EnvisionGForce/Practicum/README.md

# ECE411 Practicum Project

**Team:** Envision GForce (Team 16)

**Members:** Thomas Harris, Jacbob Metoxen, Eric Schulte, Seth Starr

**Advisor:** Andrew Greenberg

**Project Description:** Intuitive Lateral G-Force Display (Direction and magnitude)
