EnvisionGForce/Practicum/Practicum HW/3x_Practicum_Ideas.txt

Envision GForce (Team 16)
10/17/2019
ECE 411
HW 2: 3x Practicum Ideas

1. Chosen idea: Intuitive Lateral G-Force Display (Direction and magnitude)

This device will display the direction and magnitude of lateral acceleration vectors. A basic conceptual description of the output display can be seen on the left side in this video: https://www.youtube.com/watch?v=zJRh9FG83d0. 

The purpose is to intuitively and instantaneously convey the direction and magnitude of the lateral acceleration acting upon the device (or an object the device is attached to).

The sensor will be an accelerometer, or a set of accelerometers, which will output direction and magnitude data to the processor. We plan on using either the ATMega328 or the ATMega32U4 for the processor in our device. The actuator will either be a matrix of LEDs, or perhaps an LCD screen if we can figure out the necessary coding.

Our initial idea is to have a '*-shaped' matrix consisting of 3-5 LEDs on each of the 6 lobes. Each lobe will indicate a rough direction, and the number of illuminated LEDs will indicate magnitude. It would be cool to also display the magnitude numerically using an LCD or 7-segment display.

2. Weather Station

This device will function as a mini weather station that can display temperature, wind speed, wind direction, and humidity. The various sensors will interface with a microcontroller and display to an LCD on the device. The sensors needed should be readily available and relatively easy to interface with. If possible, this device could also connect to the internet and be able to display weather info on a website. Since this device will need to be outside it must be in a weather proof case.

3. Drone

This device would be able to stabalize itself in the air. It would not be able to be controlled by a user but would instead be able to perform a set of instructions that are pre-programmed, such as follow the nearest object in motion or a line on the floor/wall. 

The sensors required would be an accelerometer for the motion data to be interpreted by the rest of the flight controller, the processor, a button or buttons to control the desired task upon takeoff, and several motors equipped with propellers.
