EnvisionGForce/Practicum/Materials/Detailed_Design.pdf

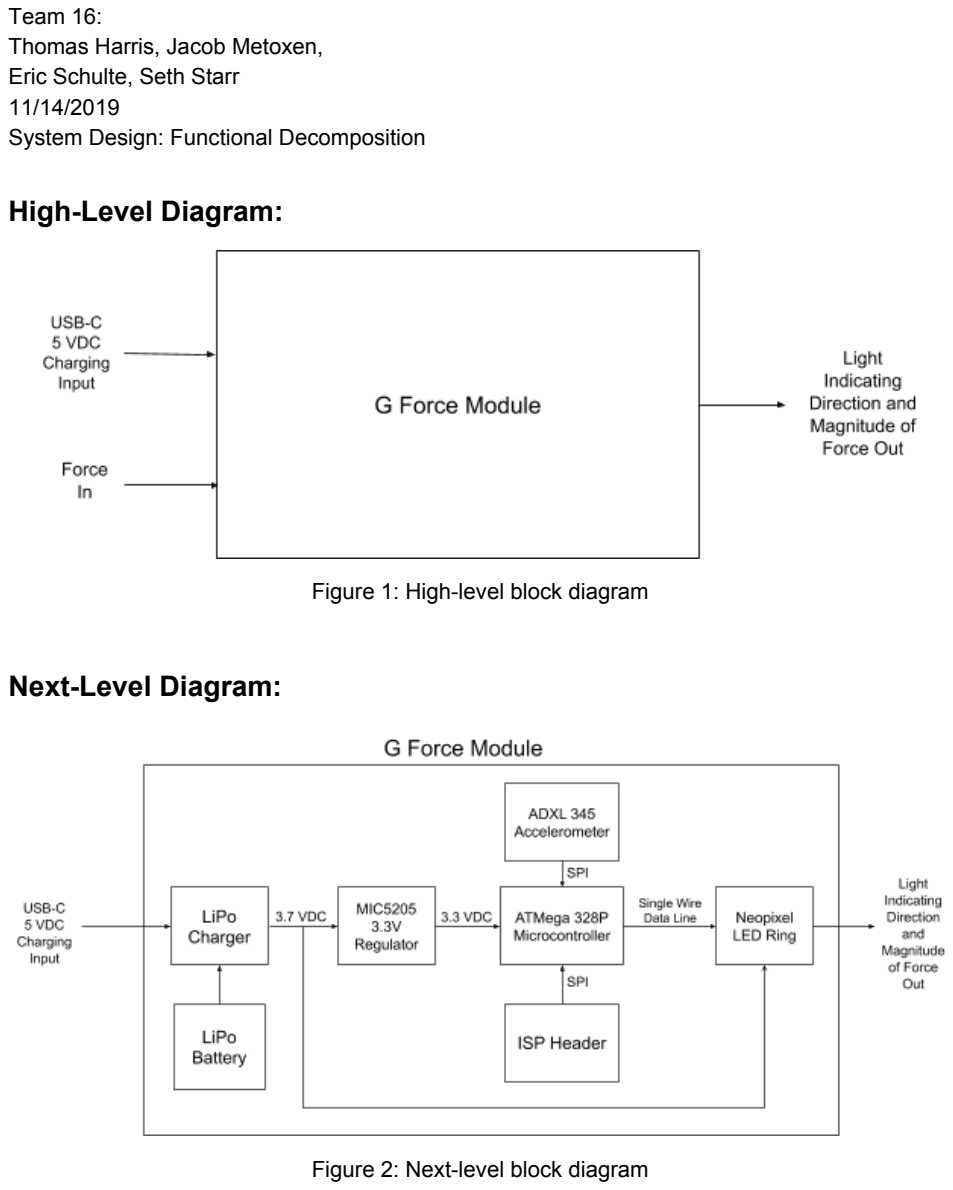
[picture p1: page 1]

Team 16:
Thomas Harris, Jacob Metoxen,
Eric Schulte, Seth Starr
11/14/2019
System Design: Functional Decomposition

### High-Level Diagram:

Figure 1: High-level block diagram

### Next-Level Diagram:

Figure 2: Next-level block diagram

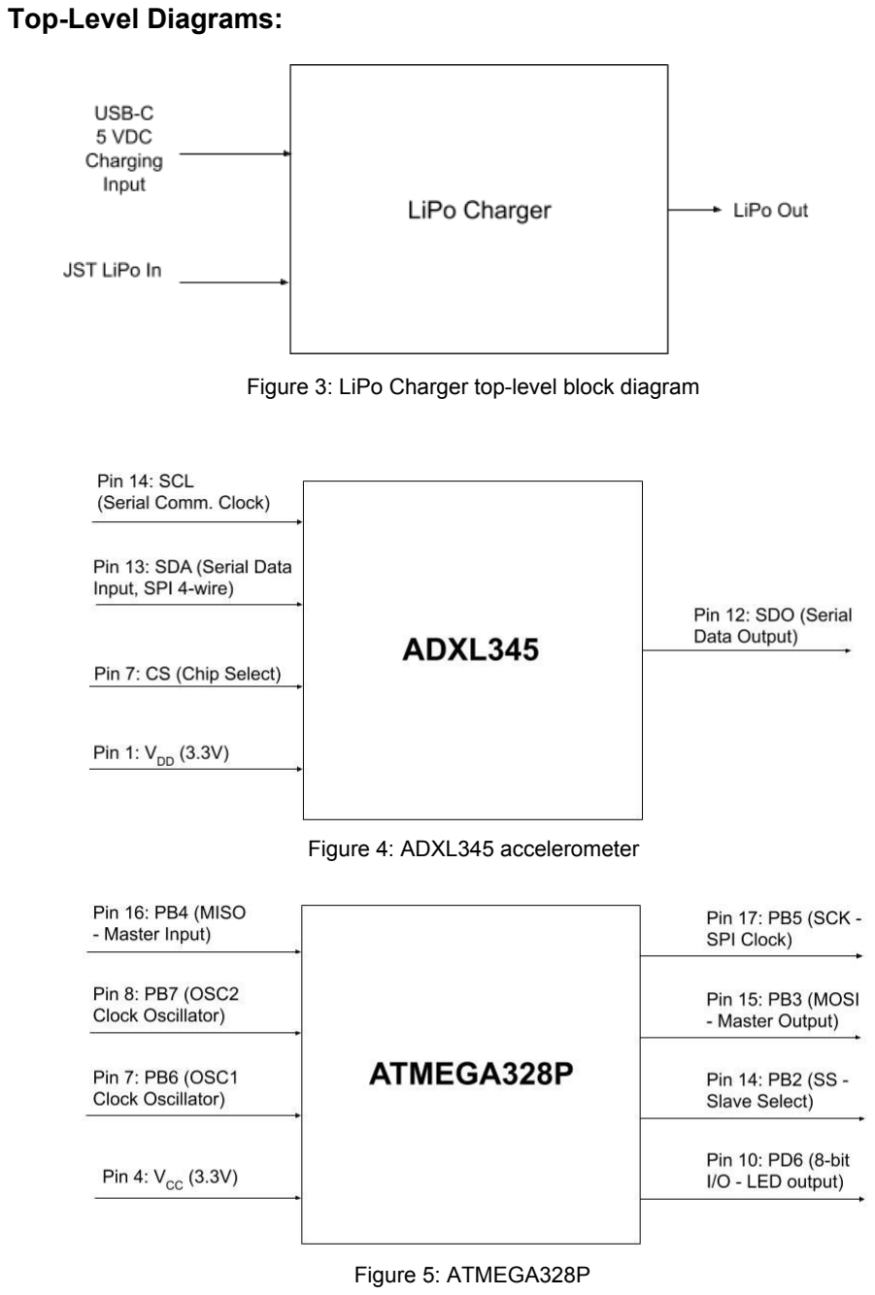
[picture p2: page 2]

### Top-Level Diagrams:

Figure 3: LiPo Charger top-level block diagram

Figure 4: ADXL345 accelerometer

Figure 5: ATMEGA328P

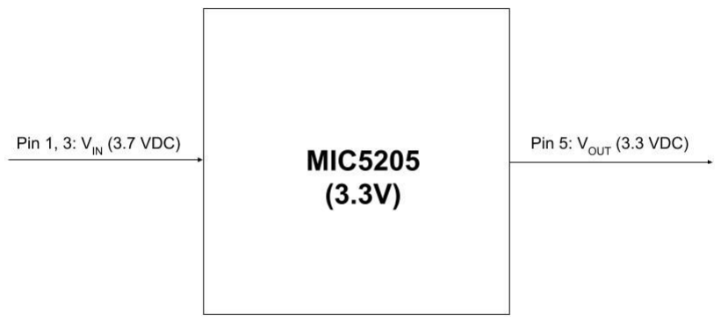
[picture p3: figure]

Figure 6: MIC5205 3.3V regulator

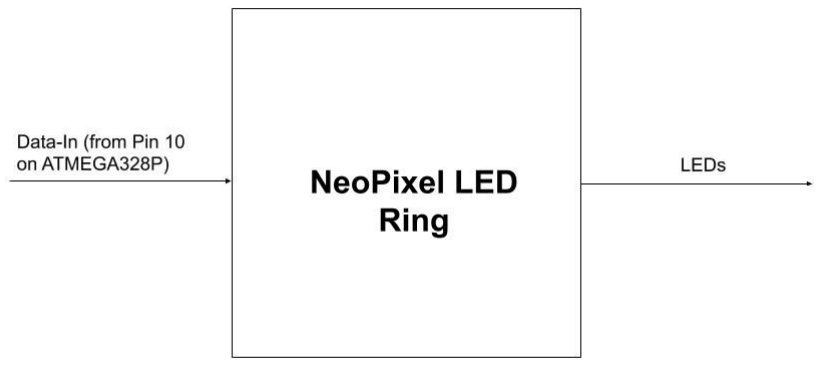
[picture p4: figure]

Figure 7: NeoPixel LED Ring
