EnvisionGForce/Practicum/Datasheets/ADXL345 Range Settings.png

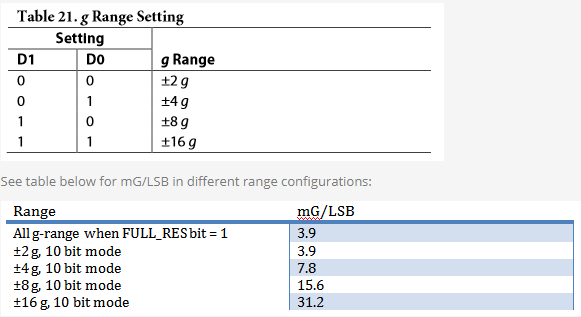
Datasheets/ADXL345 Range Settings.png
