EnvisionGForce/Practicum/Materials/BOM.xlsx

Qty | Value | Device Name | Reference Designator | Description | Manufacturer | Manufacturer Part Number | Unit Price | Total Price | Project Total Price
1 | 3.7 V / 1 Ah | CONN_02PTH3 | LIPO_IN | 3.7 V @ 1 Ah Lithium Ion Battery | SparkFun Electronics (https://www.digikey.com/en/supplier-centers/s/sparkfun) | PRT-13813 (https://www.digikey.com/product-detail/en/sparkfun-electronics/PRT-13813/1568-1492-ND/6605198) | $9.95 | $9.95 | $38.52
1 | 3.5 V / 60 mA | CONN_03LOCK_LONGPADS | LED_OUT | ADDRESS LED RING SERIAL RGB | adafruit | 1643 (https://www.digikey.com/products/en?mpart=1643&v=1528) | $7.70 | $7.70
1 | 20.00 MHZ 10.0PF | CRYSTALPTH-HC49UV | Y2 | 20MHz ±50ppm Crystal 10pF 60 Ohms 4-SMD, No Lead | EPSON (https://www.digikey.com/en/supplier-centers/e/epson) | FA-238 20.0000MB-K0 | $0.36 | $0.36
2 | 0.1uF | 0.1UF-0402-16V-10% | C3, C4 | 0.1¬µF ceramic capacitors | Murata Electronics (https://www.digikey.com/en/supplier-centers/m/murata-electronics) | GCM155R71C104KA55J (https://www.digikey.com/product-detail/en/murata-electronics/GCM155R71C104KA55J/490-7998-1-ND/4380283) | $0.10 | $0.20
8 | 10k | 10KOHM-0402-1/16W-1% | R1, R2, R3, R4, R5, R6, R7, R8 | 10kŒ© resistor | Yageo (https://www.digikey.com/en/supplier-centers/y/yageo) | RC0402FR-0710KL (https://www.digikey.com/product-detail/en/yageo/RC0402FR-0710KL/311-10.0KLRCT-ND/729470) | $0.10 | $0.80
1 | 10uF | 10UF-POLAR-0603-6.3V-20%(TANT) | C5 | 10.0¬µF polarized capacitors | Murata Electronics (https://www.digikey.com/en/supplier-centers/m/murata-electronics) | GRM155C80J106ME11D (https://www.digikey.com/product-detail/en/murata-electronics/GRM155C80J106ME11D/490-13233-2-ND/5877396) | $0.21 | $0.21
2 | 22pF | 22PF-0603-50V-5% | C1, C2 | 22pF ceramic capacitors | Murata Electronics (https://www.digikey.com/en/supplier-centers/m/murata-electronics) | GRM0335C1H220JA01D (https://www.digikey.com/product-detail/en/murata-electronics/GRM0335C1H220JA01D/490-6123-2-ND/2542169) | $0.10 | $0.20
1 | 3.3V/150mA | V_REG_MIC52053.3V | U4 | V_REG MIC5205 Standard 3.3V, 5V, and Adjustable 150mA LDO voltage regulator in SOT-23 layout. | Microchip Technology | MIC5205-3.3YM5-TR (https://www.digikey.com/product-detail/en/microchip-technology/MIC5205-3.3YM5-TR/576-1259-2-ND/771728) | $0.40 | $0.40
1 | ADXL345 | ADXL345 | U3 | Analog Devices ADXL345 3-Axis SPI/I2C 2/4/8/16g Accelerometer | Analog Devices Inc. | ADXL345BCCZ (https://www.digikey.com/product-detail/en/analog-devices-inc/ADXL345BCCZ/ADXL345BCCZ-ND/2034829) | $7.33 | $7.33
1 | ATMEGA328P_TQFP | ATMEGA328P_TQFP | U1 | AVR AVR® ATmega Microcontroller IC 8-Bit 20MHz 32KB (16K x 16) FLASH 32-TQFP (7x7) | Microchip Technology | ATMEGA328PB-AUR (https://www.digikey.com/product-detail/en/microchip-technology/ATMEGA328PB-AUR/ATMEGA328PB-AURTR-ND/5638753) | $1.42 | $1.42
1 | 3.75V-6V / 1000 mAh | Sparkfun Lipo Charger Plus | LIPO_CHARGE | LIPO CHARGER PLUS, USB - C Lithium Ion Charger | SparkFun Electronics (https://www.digikey.com/en/supplier-centers/s/sparkfun) | PRT-15217 (https://www.digikey.com/products/en?mpart=PRT-15217&v=1568) | $9.95 | $9.95
