EnvisionGForce/Practicum/Schematics/Team16_SolderStencil.dxf

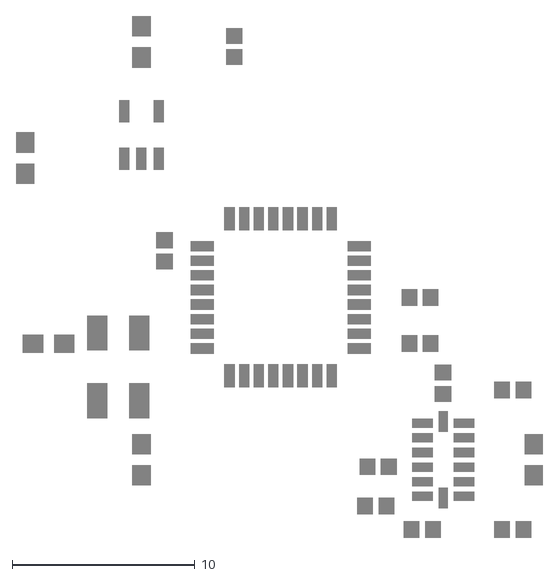
[picture p8: CAD file, 2019-11-21]
Schematics/Team16_SolderStencil.dxf
28.8 x 28.5
