EnvisionGForce/Practicum/Schematics/NEOPIXEL_MEASURE_DXF.dxf

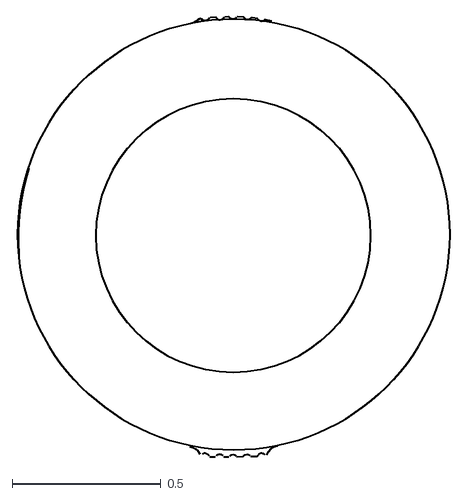
[picture p9: CAD file, 2019-11-08]
Schematics/NEOPIXEL_MEASURE_DXF.dxf
1.46 x 1.48
