EnvisionGForce/Practicum/Meeting Notes/Notes10_15.pdf

## 1015 Meeting

to

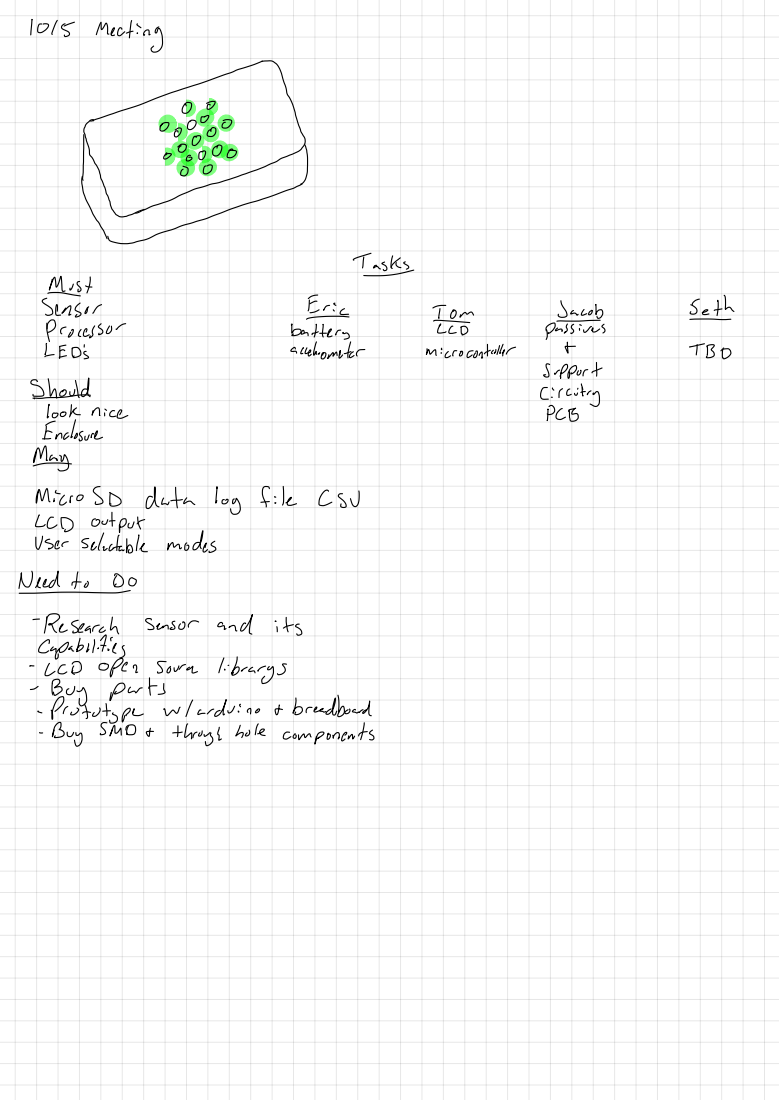
[picture p10: page 1]
tasks; Mist; sensor; Erie; Iem; Jacob; Seth; Processor; battery; LCD; passives; accelerometer; microcontroller; TBD; Support; Should; circuitry; look nice; PCB; Enclosure May; MicroSD; data; log; file; CSU; output; User; selectable; modes; Needtodo; Research; and; its; capabilities; LCD open; source; library s; Buy; parts -; Prototype; w/ arduino; breadboard; Buy SMD; through; hole; components
