EnvisionGForce/Practicum/Schematics/Board_FINAL.pdf

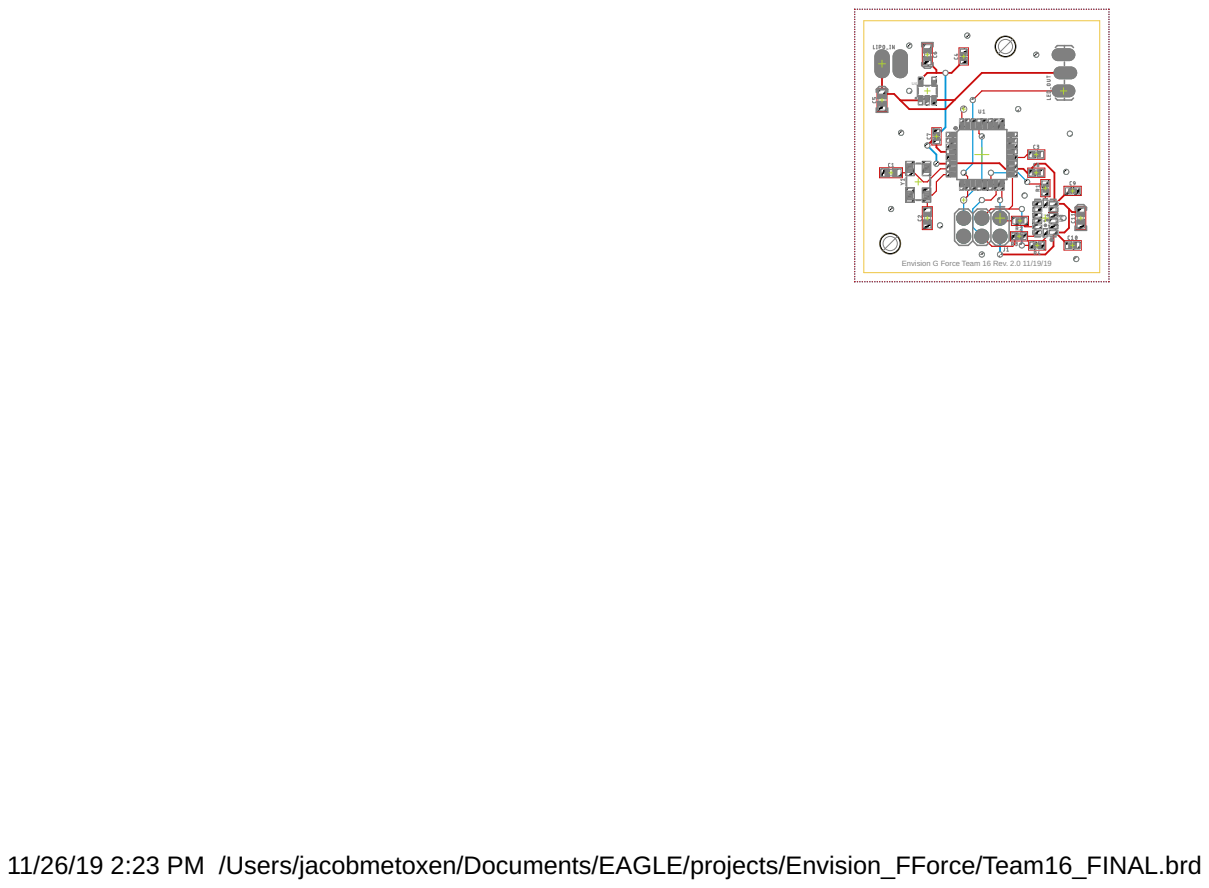
[picture p11: page 1]

Envision G Force Team 16 Rev. 2.0 11/19/19

11/26/19 2:23 PM /Users/jacobmetoxen/Documents/EAGLE/projects/Envision_FForce/Team16_FINAL.brd
