EnvisionGForce/Practicum/Schematics/Team16_FINAL.brd

## EAGLE design Schematics/Team16_FINAL.brd (2019-11-21)

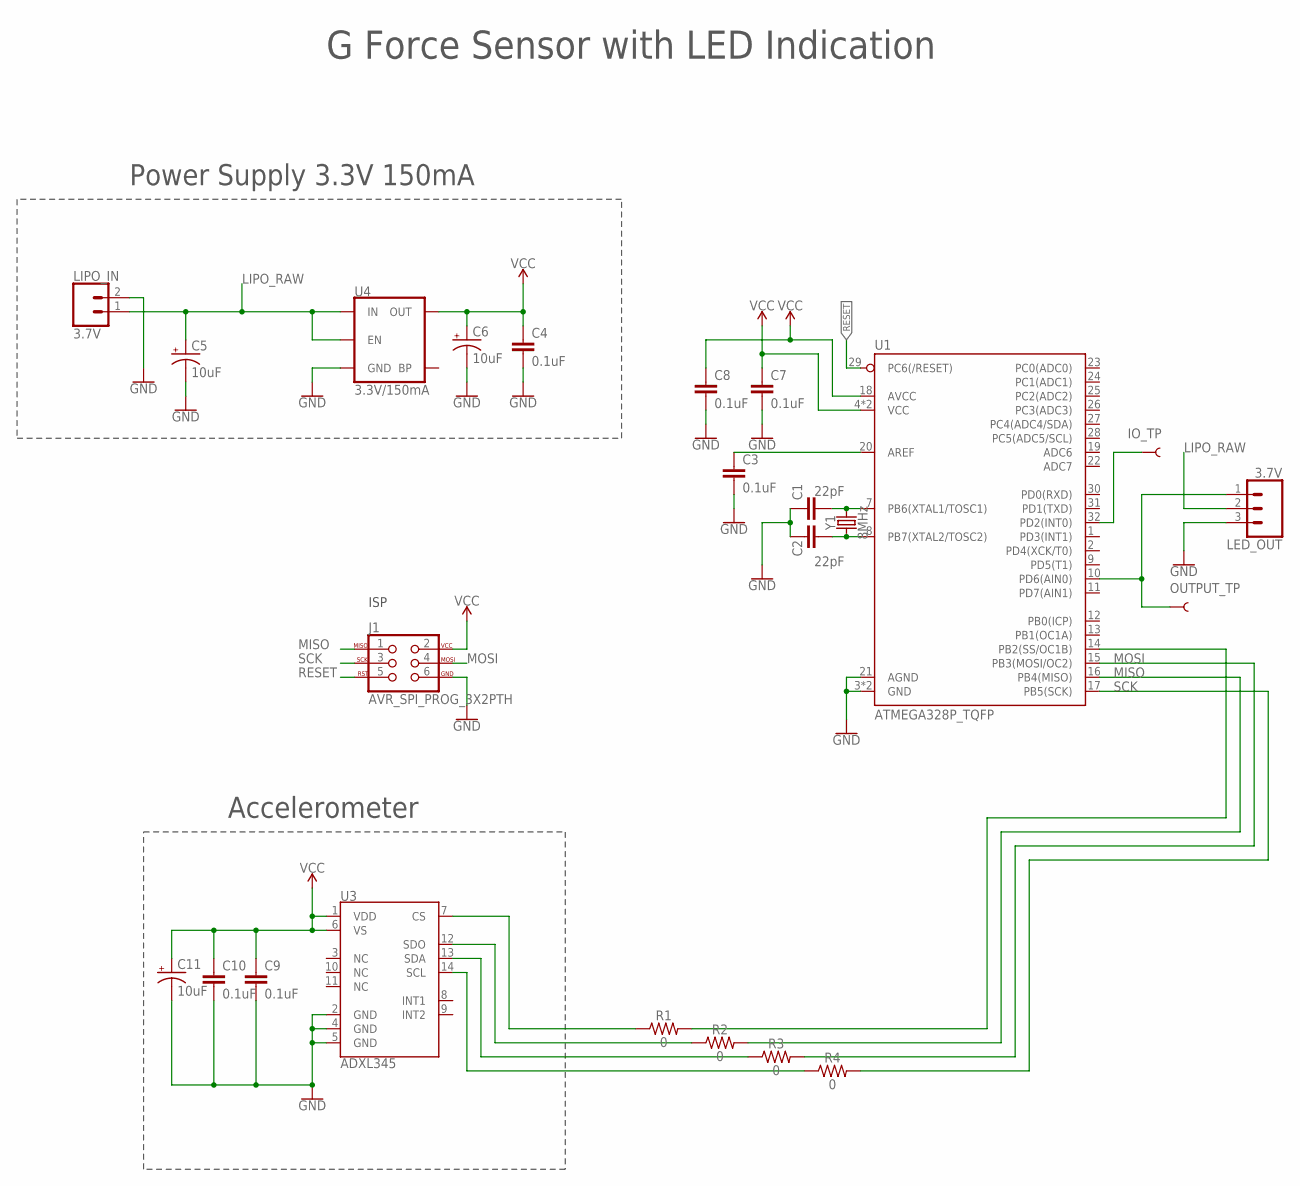
[picture p12: schematic Team16_FINAL.sch]

Parts:
C1, C2: 22pF; 0603
C3, C4, C7, C8, C9, C10: 0.1uF; 0402
C5, C6, C11: 10uF; 0603-POLAR
IO_TP: TEST-POINT3; PAD.03X.03
J1: AVR_SPI_PROG_3X2PTH; 2X3
LED_OUT: 3.7V; 1X03_LOCK_LONGPADS
LIPO_IN: 3.7V; 1X02_LONGPADS
OUTPUT_TP: TEST-POINT3; PAD.03X.03
R1, R2, R3, R4: 0; 0402
U1: ATMEGA328P_TQFP; TQFP32-08
U3: ADXL345; LGA-14
U4: 3.3V/150mA; SOT23-5
Y1: 8MHz; CRYSTAL-SMD-5X3.2-4PAD

Connections:
GND: C1.1, C2.1, C3.2, C4.2, C5.-, C6.-, C7.2, C8.2, C9.2, C10.2, C11.-, J1.6, LED_OUT.3, LIPO_IN.2, U1.3 (GND), U1.5 (GND), U1.21 (AGND), U3.2 (GND), U3.4 (GND), U3.5 (GND), U4.2 (GND)
LIPO_RAW: C5.+, LED_OUT.2, LIPO_IN.1, U4.1 (IN), U4.3 (EN)
MISO: J1.1, R2.2, U1.16 (PB4(MISO))
MOSI: J1.4, R3.2, U1.15 (PB3(MOSI/OC2))
unnamed: C1.2, U1.7 (PB6(XTAL1/TOSC1)), Y1.3 (2)
unnamed: C2.2, U1.8 (PB7(XTAL2/TOSC2)), Y1.1
unnamed: LED_OUT.1, OUTPUT_TP.P$1, U1.10 (PD6(AIN0))
unnamed: IO_TP.P$1, U1.32 (PD2(INT0))
unnamed: R1.1, U3.7 (CS)
unnamed: R2.1, U3.12 (SDO)
unnamed: R3.1, U3.13 (SDA)
unnamed: C3.1, U1.20 (AREF)
unnamed: R4.1, U3.14 (SCL)
unnamed: R1.2, U1.14 (PB2(SS/OC1B))
RESET: J1.5, U1.29 (PC6(/RESET))
SCK: J1.3, R4.2, U1.17 (PB5(SCK))
VCC: C4.1, C6.+, C7.1, C8.1, C9.1, C10.1, C11.+, J1.2, U1.4 (VCC), U1.6 (VCC), U1.18 (AVCC), U3.1 (VDD), U3.6 (VS), U4.5 (OUT)

Notes on the sheet:
ISP
Power Supply 3.3V 150mA
Accelerometer
G Force Sensor with LED Indication

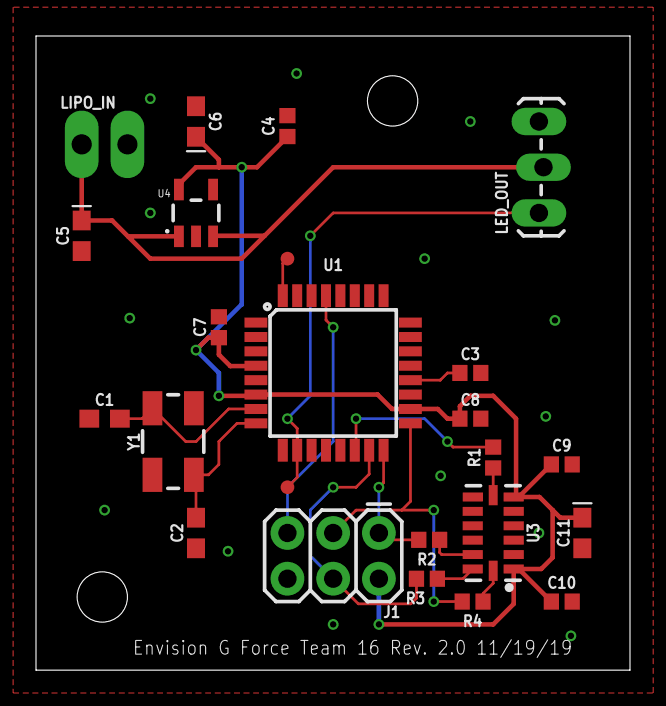
[picture p13: board Team16_FINAL.brd from above]

Board: 2 copper layers, 33.0 x 35.2 mm, 24 parts (0 on the bottom side), 17 nets.
