EnvisionGForce/Practicum/(commit log)

2019-10-20 Add files via upload
    Moved Arduino Pro Mini datasheet to 'Datasheets' folder
2019-10-20 Delete Arduino-Pro-Mini-v14-1.pdf
    Deleted from main repository. See 'Datasheets' folder.
2019-11-08 measurements and DXF for LED fixture
    measurements taken using MicroVu with InSpec.
    [NEOPIXEL_MEASURE_DXF.dxf]
2019-11-10 LED RING DXF
    DXF for the case for the LED.
    [NEOPIXEL_MEASURE_DXF.dxf]
